ChicaTriche/qiara-keypad-ha/(commit log)

2026-02-22 corrected typo in phot pcb_back
2026-02-22 corrected wiring_diagram.png path
